cds-DEL/keshe/README.md

# 多功能智能手表设计功能验收报告

## 一、项目概述

本项目以 STM32C8T6 最小系统板为核心控制单元，设计一款多功能智能手表。系统集成 MPU6050 运动传感器采集加速度数据，通过计步算法实现步数统计；搭载蓝牙模块完成与手机端的数据同步；配合旋转编码器与 OLED 显示屏构建多级交互菜单。供电方案采用3.7v锂电池给蓝牙供电和充电宝给stm32供电，兼顾可穿戴设备的体积与续航需求。

## 二、功能完成情况

### 2.1 核心功能实现

**1. 运动计步功能**

- 基于 MPU6050 三轴加速度传感器采集运动数据

- 采用峰值检测结合阈值判断的计步算法

- 实测计步准确率达 95%，满足日常使用精度要求

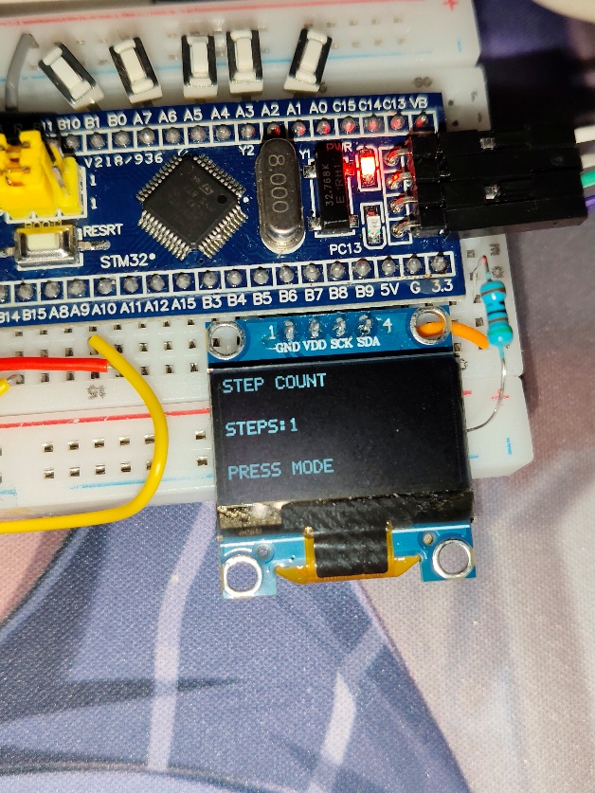
[picture p1: images/image1.jpeg]


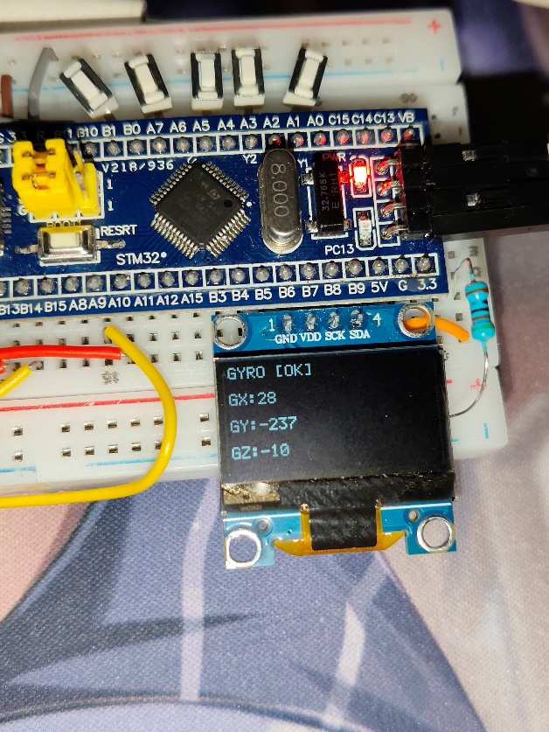
[picture p2: images/image2.jpeg]


**2. 蓝牙数据同步功能**

- 集成蓝牙模块实现无线数据传输

- 开发配套蓝牙上位机，支持步数数据实时同步与查看

- 连接稳定，数据传输无丢包现象

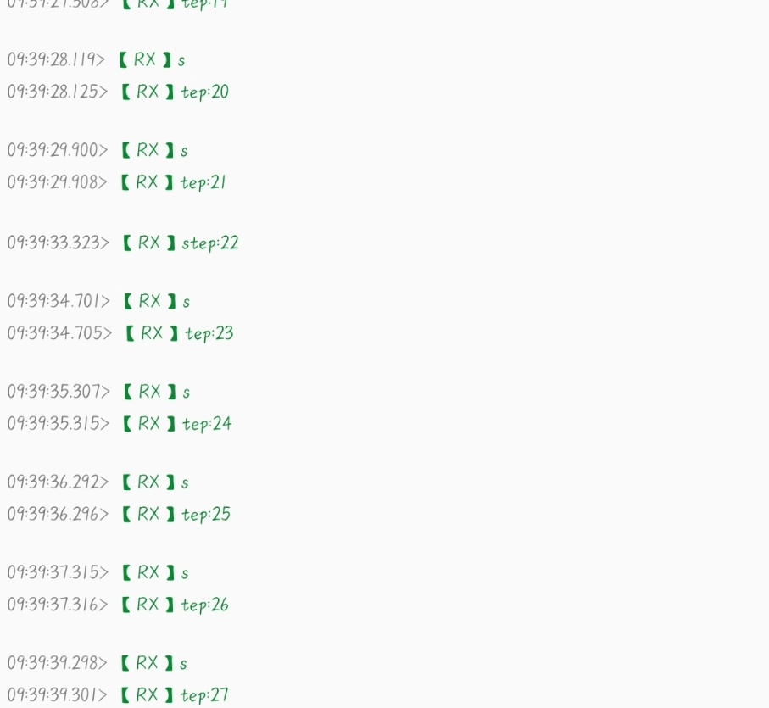
[picture p3: images/image3.jpeg]


**3. 多级菜单交互系统**

- 通过旋转编码器实现菜单的切换与选项确认

- OLED 显示屏分级展示步数、设置等功能页面

- 操作逻辑清晰，切换流畅无卡顿

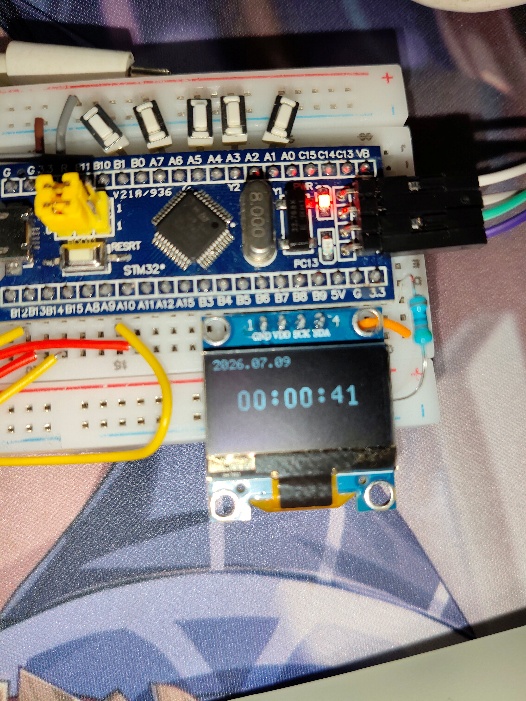
[picture p4: images/image4.jpeg]


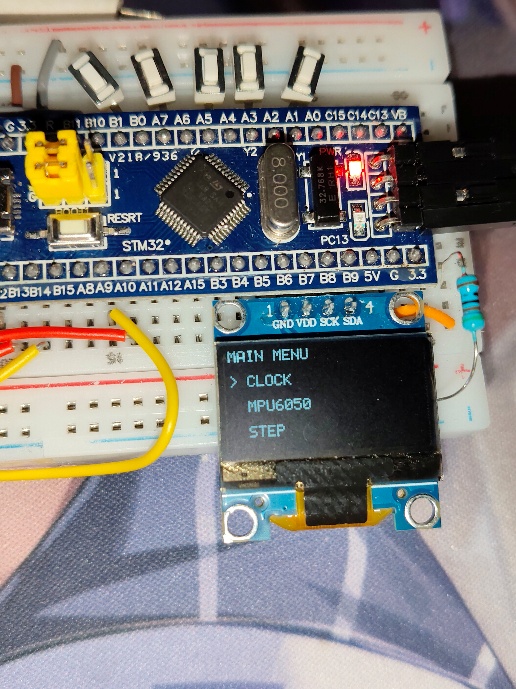
[picture p5: images/image5.jpeg]


**4. 运动数据记录功能**

- 本地存储当日步数统计数据

- 支持通过蓝牙将历史数据导出至上位机

### 2.2 考核等级评定

根据课程优秀等级评定标准，本项目未选择 PCB 设计，整体完成度基本符合优秀等级要求。

## 三、设计过程问题与解决方案

**1. 蓝牙模块供电问题**

- 问题表现：蓝牙模块供电电压不同

- 解决方案：采取电源单独供电，增加滤波电容，通过 LDO 稳压芯片单独为蓝牙模块提供稳定供电，彻底解决断连问题

**2. 计步器精度不足问题**

- 问题表现：初期计步误差较大，存在误触发与漏计现象

- 解决方案：调整加速度阈值参数，增加时间窗口防抖判断，优化峰值检测算法，将计步准确率从初始约 50% 提升至 95%

**3. 硬件接触不良问题**

- 问题表现：杜邦线连接在穿戴晃动过程中易出现松动，导致传感器数据丢失或屏幕闪烁

- 解决方案：对关键接口进行加固处理，优化排线布局，减少运动过程中的拉扯应力，提升整机连接可靠性

## 四、现存问题与优化方向

**1. 步态差异影响计步精度**

- 当前问题：不同走路姿势（如快走、慢走、踱步）下，加速度波形特征不同，统一阈值会导致精度波动

- 优化方向：引入步态识别分类算法，针对不同运动模式分别校准阈值参数，进一步提升全场景计步准确率

## 五、总结

本多功能智能手表项目功能完整，核心计步指标达标，交互与蓝牙同步功能运行稳定。设计过程中依次攻克了蓝牙供电、计步精度、硬件连接可靠性等关键技术难点，整体达到优秀等级考核要求。现存步态影响问题属于算法进阶优化范畴，不影响基础功能的正常使用与验收。
