cds-DEL/keshe/Mid-term Inspection Report.md

# 项目中期检查报告

## 一、物料到位总览
本项目全部所需物料均已到货，无物料缺失、延期情况。
物料明细：STM32F103最小系统板、MPU6050六轴传感器、HC05蓝牙模块、SSD1306 OLED显示屏、EC11旋转编码器、HT7333 LDO降压芯片、3.7V单节锂电池、分压电阻、滤波电容、杜邦线、充电宝等供电配套配件。

## 二、当前完成进度
### 1. 已完成工作
1. 硬件整体电路搭建，各模块基础接线、布局完成；
2. 使用STM32CubeMX完成工程初始化，成功移植FreeRTOS实时操作系统；
3. 全部基础功能软件代码开发完毕：
    - OLED多页面界面切换、EC11编码器旋钮/按键交互逻辑；
    - 设备实时时钟计时功能；
    - MPU6050三轴加速度、陀螺仪原始数据读取；
    - HC05蓝牙串口双向数据收发传输；
    - 基础版陀螺仪阈值计步代码；
4. 各外设独立模块USB供电测试，单项功能运行正常。

### 2. 进行中工作
1. 计步算法优化：新增加速度峰谷检测，搭配陀螺仪联合校验，降低误计、漏步；
2. 锂电便携供电电路调试，解决蓝牙上电失败、震动断电故障；
3. 时钟拓展功能方案设计，计划增加日期、星期显示。

### 3. 未开始工作
1. 整机长时间稳定性压力测试；
2. 全功能联调验收；
3. 项目完整文档、演示素材整理。

## 三、硬件调试情况
### 1. 各模块测试结果
| 硬件模块 | 测试状态 | 现象说明 |
| ---- | ---- | ---- |
| STM32主控、OLED、EC11、MPU6050 | 正常 | USB供电下数据读取、屏幕刷新、菜单切换无异常 |
| HC05蓝牙模块 | 异常（锂电供电） | USB板载3.3V供电可点亮、正常收发；锂电池经HT7333降压供电时无法上电 |
| HT7333电源电路 | 空载正常 | 输入、输出均加装滤波电容，无负载时稳定输出3.3V，带载能力不足 |

### 2. 当前硬件问题与解决措施
#### 问题1：3.7V锂电池+HT7333供电时，HC05蓝牙模块无法上电点亮
- 故障原因：HT7333最大输出电流仅100mA；STM32+OLED+MPU静态负载约40~60mA，HC05上电峰值电流70~80mA，瞬时总电流超出芯片额定值，触发限流，电压跌落导致蓝牙欠压保护。
- 整改方案：
  1. 优先方案：双路独立稳压供电，锂电池分出两路，一路HT7333给主控与传感器，第二颗HT7333单独为HC05供电，所有模块GND共地；
  2. 备选方案：更换大电流低压差LDO（XC6206-3.3，额定500mA输出）替换HT7333，满足整机峰值电流需求。

#### 问题2：锂电池供电时，设备晃动、移动过程中偶尔断电重启
- 故障原因：
  1. 供电接线、焊点存在虚接，震动时供电回路断开；
  2. 瞬时负载电流波动大，现有电容缓冲能力不足，动态压降过大。
- 整改方案：
  1. 重新焊接全部电源、地线引脚，加粗共地导线，缩短电源走线长度，降低线路内阻；
  2. 在LDO输出端、HC05电源引脚额外并联10μF钽电容，提升瞬时电流缓冲能力。

## 四、软件调试情况
### 1. 各功能模块开发进度
| 功能模块 | 开发状态 | 测试结果 |
| ---- | ---- | ---- |
| OLED界面+EC11编码器菜单切换 | 已完成 | 多页面切换流畅，旋钮、按键响应无卡顿、丢指令 |
| 实时时钟基础计时 | 已完成 | 计时稳定，基础时钟页面正常渲染 |
| MPU6050六轴数据采集 | 已完成 | I2C通信稳定，三轴加速度、陀螺仪数据读取无丢失 |
| HC05蓝牙数据收发传输 | 已完成 | USB供电下可稳定上传步数、传感器数据 |
| 基础计步功能 | 优化迭代中 | 基础计数逻辑可用，存在甩手误计、行走漏步缺陷 |
| 时钟日期/星期拓展功能 | 未开发 | 仅完成设计方案，待硬件、计步优化完成后开发 |

### 2. 已通过测试用例
1. 外设单项通信测试：I2C驱动OLED/MPU6050、USART蓝牙收发全部稳定通过；
2. FreeRTOS多任务并发测试：屏幕刷新、传感器采集、蓝牙后台传输并行运行，无任务阻塞；
3. 编码器交互测试：旋转切换光标、短按切换页面功能无异常。

## 五、存在的问题、风险及应对方案
### 1. 技术难点风险
1. **计步算法精度不足**
    - 风险：仅依靠陀螺仪单阈值判断，原地甩手、颠簸震动会产生误计数，正常行走存在漏步，计步误差过大。
    - 应对：完善加速度+陀螺仪双重校验逻辑，新增合加速度峰谷检测；增加滑动均值滤波消除传感器噪声；设置最小迈步时间防抖锁，过滤短时间虚假触发。
2. **锂电便携供电不稳定**
    - 风险：蓝牙无法上电、震动断电会直接导致项目便携核心功能失效。
    - 应对：优先实施双LDO独立供电方案，同步完成接线加固、电容扩容；整改后进行1小时手持震动压力测试，验证供电稳定性。

### 2. 项目进度风险
- 风险：硬件电源整改、计步算法优化耗时较长，可能延后时钟拓展、整机联调工作。
- 应对：小组并行分工，硬件、软件同步推进；提前搭建时钟日期功能代码框架，硬件故障修复后快速完成拓展功能开发。

## 六、后续工作计划（至项目验收前）
### 阶段1（1日内）：硬件供电故障整改
1. 加装第二路HT7333，实现HC05独立供电，重新焊接所有电源、地线；
2. 锂电池手持震动测试，验证蓝牙稳定上电、整机无断电重启。

### 阶段2（2日内）：软件功能完善
1. 完成加速度+陀螺仪联合校验计步代码调试，多次行走实测，控制误步、漏步误差；
2. 开发时钟页面日期、星期拓展功能，整合进原有界面逻辑。

### 阶段3（1日内）：整机全功能联调
1. 锂电池供电下全功能同步测试：时钟、计步、菜单交互、蓝牙数据传输；
2. 修复联调产生的屏幕卡顿、数据乱码、显示异常等bug。

### 阶段4（验收前1日）：收尾准备
1. 长时间整机稳定性压力测试；
2. 整理工程代码、硬件接线图纸、演示视频、全套项目文档，准备验收展示材料。

### 小组分工调整
1. 硬件负责人：电源电路改造、焊接、整机硬件测试；
2. 算法负责人：计步滤波、双条件校验代码迭代优化；
3. 界面软件负责人：时钟日期拓展功能开发、OLED界面美化；
4. 统筹负责人：整机联调测试、中期/验收文档整理。
