cds-DEL/keshe/sysDesign.md

# 基于STM32F103C8T6的智能手表系统设计文档
小组成员：李盛杰、陈冬胜、郑開之<br>
编制日期：2026年07月01日<br>
项目实现形式：STM32最小系统板+面包板搭建硬件，无PCB设计<br>
实现功能范围：全部基础功能 + 扩展1（旋转编码器多级菜单）+ 扩展2（蓝牙数据同步与上位机）+ 扩展4（运动计步算法与数据记录）

## 1 物料到位情况说明
### 1.1 已有物料清单（全部到位）
本小组前期自备器材完好可用，无需采购、无需等待到货，可直接用于项目开发，具体清单如下：
- STM32F103C8T6最小系统板：项目主控核心，正常上电、下载程序无故障
- 1.3寸 I2C接口OLED显示屏：用于系统界面、时间、传感器数据、菜单显示
- ST-Link V2下载器：用于程序烧录、在线调试
- 面包板、杜邦线、基础工具包：用于硬件电路搭建与接线

### 1.2 待采购物料清单（未到货）
本次项目扩展功能所需外设模块、电源配套器件均已统一采购，截至2026年07月01日暂未到货，预计2026年07月03日全部到货，可保障07月06日中期检查节点顺利完成硬件搭建与基础调试。具体采购物料明细如下：

| 物料名称 | 型号规格 | 用途 |
|---|---|---|
| MPU6050/GY521六轴陀螺仪模块 | I2C通信、2.54mm直插引脚，适配面包板 | 采集三轴加速度、角速度数据，为计步算法、姿态检测提供原始数据 |
| EC11旋转编码器 | 带按键直插款，适配面包板 | 实现多级菜单切换、功能选择、参数调节 |
| HC-05蓝牙串口模块 | 2.54mm直插排针，串口透传 | 实现手表与手机上位机数据同步、指令交互 |
| TP4056 Type-C充电保护模块 | Type-C接口，支持锂电池充电与过充保护 | 系统电源充电管理，实现外接供电充电功能 |
| 3.7V锂电池 | 6516 150mAh，带保护板、2.0插头引线 | 系统离线续航供电 |
| HT7333 LDO稳压芯片 | TO92直插封装，3.3V稳压输出 | 为MCU、传感器、显示屏提供稳定3.3V工作电压 |
| 1N4148开关二极管 | 轴向直插2.54mm引脚 | 电源电路防反接、电路保护 |
| 电阻电容套件 | 1k/10k/47k电阻、100nF/10uF电容，1/4W直插 | 电路限流、滤波、外设匹配 |

## 2 系统总体方案设计
### 2.1 系统设计总体概述
本项目基于STM32F103C8T6主控芯片，以FreeRTOS实时操作系统为核心，搭建多功能嵌入式智能手表系统。系统集成电源管理、OLED显示、姿态传感采集、编码器人机交互、蓝牙数据通信、运动计步六大核心功能，采用面包板搭建硬件电路，无PCB设计。通过多任务实时调度实现界面刷新、传感器采样、数据运算、蓝牙交互并行运行，最终实现时间显示、姿态检测、多级菜单操作、运动计步记录、手机蓝牙数据同步等完整功能，满足课程设计基础要求及多项扩展要求。

### 2.2 系统四层总体架构
1. 硬件层：包含主控最小系统、电源模块、OLED显示模块、MPU6050传感模块、EC11编码器模块、HC-05蓝牙模块，为系统提供硬件运行基础。
2. 驱动层：基于STM32标准库开发I2C驱动、串口驱动、定时器驱动、编码器中断驱动，实现底层硬件的读写与控制。
3. RTOS系统层：移植FreeRTOS内核，完成任务划分、优先级配置、信号量与消息队列通信配置、SysTick时钟节拍配置，实现多任务实时调度。
4. 应用功能层：实现时间计时、OLED界面显示、姿态数据解析、多级菜单交互、计步算法运算、运动数据存储、蓝牙数据同步等上层业务功能。

### 2.3 硬件架构示意图（文字框图）
```
                    手机上位机
                        ↑
                        │
                        ↓
               HC-05蓝牙模块 (USART串口)
                        ↑
                        │
                        ↓
电源模块(TP4056+HT7333) → STM32F103C8T6主控 ← EC11编码器(外部中断)
                        ↓
                        │
                        ↓
              OLED显示屏  ←I2C总线→  MPU6050陀螺仪
                        ↑
                        │
                        ↓
              SysTick定时器(计时+RTOS节拍)
```

### 2.4 软件系统流程图（文字版）
```
系统上电
    ↓
硬件外设初始化(GPIO/I2C/USART/TIM/EXTI)
    ↓
底层驱动初始化(OLED/MPU6050/编码器/蓝牙)
    ↓
FreeRTOS内核初始化(堆内存、任务、信号量、消息队列)
    ↓
开启全局中断，启动任务调度器
    ↓
多任务并行循环运行：
    1.时间更新任务  2.OLED显示任务  3.传感器采集任务
    4.计步运算任务  5.菜单交互任务  6.蓝牙通信任务
    ↓
实时采集数据、运算计步、刷新界面、响应蓝牙指令
    ↓
持续循环调度运行
```

## 3 硬件详细设计
### 3.1 核心主控电路设计
主控采用STM32F103C8T6最小系统板，板载复位电路、8MHz外部晶振、BOOT启动配置电路，无需自行绘制核心电路。全板外设统一由HT7333输出3.3V供电，匹配MCU额定工作电压。

### 3.2 电源电路设计
电源系统分为充电电路与稳压供电电路两部分：
- 充电电路：TP4056 Type-C一体化充电模块，支持5V外接输入为3.7V锂电池充电，内置过充、过放、短路保护。
- 稳压电路：锂电池输出电压范围3.0~4.2V，经过HT7333线性LDO稳压至稳定3.3V；串联1N4148二极管实现电源防反接，输入输出端并联100nF滤波电容，降低电压纹波。

### 3.3 外设接口电路设计
#### 3.3.1 I2C外设电路（OLED+MPU6050）
主控硬件I2C1引脚：PB6(SCL)、PB7(SDA)，两条总线各外接10kΩ上拉电阻至3.3V。OLED与MPU6050挂载同一组I2C总线，依靠不同设备地址区分通信对象，节省IO资源，布线简洁。

#### 3.3.2 EC11旋转编码器电路
编码器A、B两相引脚分别接入PA0、PA1外部中断引脚，中间按键引脚接入PA2普通GPIO；编码器公共端接GND，IO口内部上拉，双边沿中断检测旋转动作，实现菜单切换、数值调节，短按确认菜单选项。

#### 3.3.3 HC-05蓝牙串口电路
HC-05模块TX接STM32 USART1 RX(PA10)，HC-05 RX接STM32 USART1 TX(PA9)；模块VCC接3.3V，GND共地，波特率固定9600，8N1串口模式，实现双向透传数据交互。

### 3.4 关键元件参数计算
1. 稳压参数：HT7333输入耐压12V，压差仅0.3V，锂电池3.0~4.2V输入可稳定输出3.3V，满足所有外设工作电压。
2. I2C上拉电阻：10kΩ匹配400kHz高速I2C时序，总线电平稳定，无通信丢包。
3. 整机功耗估算：系统静态运行电流约20mA，150mAh锂电池理论续航7.5小时，完全满足实验室调试需求。

### 3.5 硬件布局规划（面包板无PCB）
1. STM32最小系统板放置面包板中间区域，缩短所有外设接线长度，减少信号干扰；
2. 电源模块、锂电池统一布置在面包板最左侧，远离I2C、串口信号线；
3. OLED显示屏、EC11编码器布置外侧，方便实时观察界面与手动操作；
4. MPU6050、HC-05蓝牙分区放置，电源线与信号排线分开走线；
5. 模块分区清晰，接线有序，便于后期故障排查、线路整改。

## 4 软件详细设计
### 4.1 软件整体模块划分
系统软件分层模块化开发，七大核心模块相互解耦：
底层驱动模块、系统计时模块、FreeRTOS任务调度模块、OLED显示UI模块、传感器采集&计步模块、编码器菜单交互模块、蓝牙通信模块。

### 4.2 FreeRTOS任务划分与调度设计
系统采用抢占式调度，SysTick配置1ms系统节拍，共创建6个独立任务，参数如下：

| 任务名称 | 优先级 | 堆栈大小 | 任务功能 | 运行机制 |
|---|---|---|---|---|
| 时间更新任务 | 4（最高） | 128 | SysTick累加计时，更新时分秒全局变量 | 1s周期阻塞运行 |
| 传感器采集任务 | 3 | 256 | 定时读取MPU6050三轴加速度、角速度 | 10ms定时采集 |
| 计步运算任务 | 3 | 256 | 数据滤波、峰值检测、步数累加、本地存储 | 传感器数据队列触发运行 |
| OLED显示任务 | 2 | 128 | 渲染时间页、传感器数据页、多级菜单页面 | 20ms周期刷新 |
| 菜单交互任务 | 2 | 128 | 检测编码器旋转、按键事件，切换菜单层级 | 事件阻塞，无操作休眠 |
| 蓝牙通信任务 | 1（最低） | 256 | 接收手机指令、上传计步/时间数据 | 串口中断唤醒处理 |

### 4.3 任务间通信与同步设计
1. 二值信号量：I2C总线互斥信号量、OLED屏幕互斥信号量，防止多任务同时占用硬件造成通信错乱、花屏。
2. 消息队列：传感器数据队列、蓝牙收发数据队列，实现任务异步数据传输，降低耦合。
3. 阻塞休眠机制：无数据、无操作时任务进入阻塞态，释放CPU资源，降低系统整体功耗。

### 4.4 核心计步算法描述（扩展4核心）
采用滑动窗口均值滤波+三轴合成加速度峰值阈值算法：
1. 预处理：对MPU6050原始三轴加速度做5阶滑动平均滤波，滤除手部高频抖动噪声；
2. 合成加速度计算：sqrt(Ax²+Ay²+Az²)，消除手表佩戴倾斜带来的数值偏移；
3. 峰值检测：识别合成加速度连续“波峰-波谷”周期性变化；
4. 防抖阈值：设置300ms最小步间隔，过滤小幅抬手、晃动误计数；
5. 数据存储：累计当日总步数，变量缓存历史步数，支持蓝牙指令清零、数据上传手机上位机。

### 4.5 外设配置方案
1. I2C1：时钟400kHz高速模式，PB6/PB7复用I2C功能；
2. USART1：波特率9600，数据位8，停止位1，无校验，开启接收中断；
3. SysTick：1ms中断，作为FreeRTOS系统时钟节拍与软件计时基准；
4. 外部中断EXTI0/EXTI1：编码器A/B双边沿触发，上升下降沿均可检测旋转方向；
5. 低功耗配置：空闲任务开启STOP低功耗模式，闲置外设时钟关闭，降低功耗。

## 5 进度汇报
### 5.1 当前完成情况（截止2026-07-02汇报节点）
1. 完成全部基础功能、扩展1/2/4需求梳理，确定面包板硬件搭建方案，放弃PCB设计；
2. 完成自备物料清点、采购物料清单统计、项目预算核算；
3. 完成硬件框图、软件流程图、FreeRTOS任务架构、计步算法方案设计；
4. 完成STM32工程框架搭建、FreeRTOS内核移植、底层驱动函数框架编写；
5. 完成本系统设计文档全部撰写，整理小组分工、全周期项目里程碑。

### 5.2 后续工作计划
1. 2026.07.02 - 07.05：采购物料全部到货清点，完成面包板整机硬件接线，调试电源与各模块基础通信；
2. 2026.07.06 中期检查：基础OLED时间显示、MPU6050数据采集调试完成，实现基础计步逻辑，提交中期检查报告；
3. 2026.07.06 - 07.09：完善多级菜单、蓝牙双向同步、优化计步滤波算法、运动数据本地存储，整机联调修复bug，录制功能演示视频；
4. 2026.07.09 初次验收：全部基础+扩展功能完整实现，现场整机演示，记录修改意见；
5. 2026.07.09 - 07.10：根据初验意见修复软硬件缺陷，校准计步精度、优化蓝牙稳定性，整理答辩PPT；
6. 2026.07.10 最终验收：整机稳定运行，完成项目评分；
7. 验收后一周：每位组员独立完成LaTeX个人总结报告并归档。

## 6 小组分工说明
1. 陈冬胜（硬件负责人）
物料选型采购、到货核对、硬件框图绘制、面包板整机接线搭建、电源电路调试、MPU6050/OLED/编码器/蓝牙硬件故障排查、答辩讲解硬件整体方案。

2. 李盛杰（软件负责人）
STM32工程创建、FreeRTOS移植与任务划分、全套底层驱动开发、软件计时、多级菜单逻辑、三轴计步滤波算法、蓝牙上下位机通信、整机软件联调、代码整理与软件架构讲解。

3. 郑開之（文档&测试负责人）
项目计划书、系统设计文档、中期检查报告、验收材料全套撰写；计步精度、蓝牙通信、长时间稳定性专项测试；录制演示视频、制作答辩PPT；汇总硬件图纸、源代码、测试记录；答辩主讲，记录教师修改意见同步软硬件负责人。

### 公共协作任务
三人共同讨论整体系统方案，核对全部功能需求；联合整机长时间稳定性测试，验证多任务同步运行无卡顿；软硬件资料统一共享，交叉检查文档、代码错误。

## 7 可行性与风险规避
### 7.1 可行性分析
硬件全部采用通用成熟模块，资料丰富、调试门槛低；FreeRTOS任务划分逻辑清晰，通信机制成熟；计步、蓝牙、菜单功能均有成熟开源参考方案，结合组员软硬件开发能力，可完整实现全部基础与扩展功能。

### 7.2 风险及解决措施
1. 物料延期：预留3天缓冲调试周期，不影响中期检查节点；
2. 计步计数误差：多级滤波+动态阈值校准，多次实测调整参数；
3. 多任务资源冲突：信号量互斥访问硬件，合理分配任务优先级避免死锁；
4. 蓝牙通信不稳定：增加数据校验位、重传机制，优化串口中断处理逻辑。

---

## 附：核心框架示例代码
```c
/* FreeRTOS任务创建核心代码片段 main.c */
#include "stm32f10x.h"
#include "FreeRTOS.h"
#include "task.h"
#include "queue.h"
#include "semphr.h"
#include "oled.h"
#include "mpu6050.h"
#include "encoder.h"
#include "bluetooth.h"

/* 全局句柄定义 */
SemaphoreHandle_t xI2CSemaphore;
QueueHandle_t xSensorDataQueue;

/* 任务函数声明 */
void vTimeTask(void *pvParameters);
void vSensorTask(void *pvParameters);
void vStepCountTask(void *pvParameters);
void vOledDispTask(void *pvParameters);
void vMenuTask(void *pvParameters);
void vBtCommTask(void *pvParameters);

int main(void)
{
    //硬件底层初始化
    STM32_Init();
    OLED_Init();
    MPU6050_Init();
    Encoder_Init();
    Bluetooth_Init();

    //RTOS资源创建
    xI2CSemaphore = xSemaphoreCreateBinary();
    xSemaphoreGive(xI2CSemaphore);
    xSensorDataQueue = xQueueCreate(16, sizeof(MPU6050_Data));

    //创建6个业务任务
    xTaskCreate(vTimeTask, "TimeTask", 128, NULL, 4, NULL);
    xTaskCreate(vSensorTask, "SenTask", 256, NULL, 3, NULL);
    xTaskCreate(vStepCountTask, "StepTask", 256, NULL, 3, NULL);
    xTaskCreate(vOledDispTask, "OledTask", 128, NULL, 2, NULL);
    xTaskCreate(vMenuTask, "MenuTask", 128, NULL, 2, NULL);
    xTaskCreate(vBtCommTask, "BtTask", 256, NULL, 1, NULL);

    vTaskStartScheduler();
    while(1);
}

//计步算法核心片段
void Step_Calc(MPU6050_Data data)
{
    float acc = sqrtf(data.ax*data.ax + data.ay*data.ay + data.az*data.az);
    static float buf[5];
    static uint8_t idx = 0;
    static uint32_t step_time = 0;
    static uint32_t step_cnt = 0;

    //滑动平均滤波
    buf[idx++] = acc;
    if(idx >= 5) idx = 0;
    float avg = (buf[0]+buf[1]+buf[2]+buf[3]+buf[4])/5.0f;

    //峰值阈值判断+防抖间隔
    if(avg > 1.2f && (millis()-step_time)>300)
    {
        step_cnt++;
        step_time = millis();
    }
}
```
