cds-DEL/keshe/智能手表功能报告.md

- **多功能智能手表功能详细说明**

一、硬件构成

- 主控芯片：STM32C8T6 最小系统板，负责整机逻辑调度与数据处理

- 运动传感器：MPU6050 三轴加速度计，实时采集手腕运动加速度数据

- 显示模块：OLED 显示屏，用于菜单界面与步数数据展示

- 输入设备：旋转编码器，实现菜单切换与选项确认

- 蓝牙模块：负责与手机/上位机的无线数据通信

- 供电系统：3.7v锂电池给蓝牙供电和充电宝给stm32供电

二、运动计步功能

- 实现原理：通过 MPU6050 采集三轴加速度波形，识别走路时的周期性峰值特征

- 核心算法：采用阈值判断 + 时间窗口防抖的峰值检测算法，过滤误触发

- 精度指标：正常步行场景下计步准确率约 95%

- 局限：不同走路姿势（快走/慢走/踱步）下精度存在小幅波动

三、蓝牙数据同步功能

- 数据传输：将手表本地步数数据无线发送至配套上位机

- 上位机功能：蓝牙端软件可实时查看步数、同步历史记录

- 连接稳定性：优化供电后连接可靠，数据传输无明显丢包

四、多级菜单交互系统

- 操作方式：旋转编码器旋钮切换选项，按下确认进入

- 菜单层级：包含步数主页、数据查看、系统设置等多级页面

- 显示效果：OLED 屏幕界面清晰，菜单切换流畅无卡顿

五、运动数据记录功能

- 本地存储：手表端保存当日步数统计数据

- 数据导出：可通过蓝牙将记录同步至上位机进行查看与留存

- 使用场景：支持日常运动数据的累计统计与追溯

六、电源管理

- 供电方案：3.7v锂电池给蓝牙供电和充电宝给stm32供电

- 问题解决：设计初期蓝牙模块启动电流导致的供电波动已通过电路优化解决

- 可穿戴适配：整体功耗控制满足手表类设备的基本续航需求
