cds-DEL/keshe/plan.md

基于STM32F103C8T智能表项目计划书

李盛杰  陈冬胜，郑開之  
2026年06月30日

## 项目基本信息
- 课题名称：基于STM32F103C8T6的智能手设计
-组人数：人
- 实现方案：不制作PCB，采用STM32最小系统+面包板搭建硬
- 已有器材：STM32F103C86最小系统板、OLED显示屏、ST-Link V2下载器、孔迷你包，无需重复采购
- 完成要求：全部要求 + 扩展1（旋编码器+OLED多级菜单）+展2（牙手机数据同步与上位机）+ 扩4运动计步算法与运动数据记录），不开展PCB设计扩展
- 实验地点：理学馆

## 工作计划（题至验收详细时间节点与里程碑）
完全按照课程设计官方时间安排规划，各阶段里程碑如下：
1. **2026-06-29 09:00 选题确认里程碑**  
 小组确定智能手表课题，梳理基础功能、扩展1、扩展2、扩展4全部需求；确定不制作PCB，全程使用面包板搭建硬件电路，对小组已有器材清单，剔除采购物料。
   
2. **2026-06-30 09:00 项目书提交里碑**  
   完物料统计、人员分工、完整计划书写，提交指导教师审核。

3. **2026-07-02 09: 系统设计文档与分组汇报里程碑**  
  成件框图、软件流程图、FreeRTOS任务架构、外设接线示意图；完成计步算法原设计提交《系统设计文档》并上台汇报整体方案。

4. **202607-06 15:00期检查里碑**  
   全采购物料到货；面包板硬件搭建完毕；基础功能（OLED时间显示、MPU0姿态数据采集）调试通过；完成基础计步逻辑开发；提交《期检查报告》。

5. **2026--09 09:00 第一次验收里程碑**  
   全部基础功能、编码器菜单、蓝牙通信、完整计步与数据存储功能试完成；录制演示视频，现场整机演示记录教师提出的修改意见。

6. **2026--10 09:00 第二最终验收里程碑**  
  初验意见修改软硬件缺陷整机功能稳定运行，计步数据记录准确蓝牙同步正常，项目最终成绩评定7. **验收后一周 总结报告提交程碑**  
   每位组员独立使用LaTeX模板完成个人总结并提交存档。

 分阶段细化工作安排
1. 06.29--06.30：需求梳理、物料清单整理、剔已有器材人员分工、撰本项目计划书，确定计步算法实现方案
2.  06.30--.02：硬件接线方案设计、FreeRTOS工程搭、外设驱动架编写计步算法逻辑设计、设计文档撰写
3. 06.30–07.02.：物料收货清点、面包板硬件接线、各外设动试、多任务联调、计步功能调试
4. 07.02--07.09：优化计步滤算法、增加运动数据存储记录、蓝牙上位机双向通信调试、整机全测试、录制演示视频、整理验收材料
5. 07.09--07.10修复初验提出Bug、整机复测、计步精校准、准备答辩演示材料

## 物料采购计划
| 料名称 | 型规格 | 小计元) | 购买途径 |
|---|---|---|---|
| MPU6050/GY521六轴陀螺仪模块 | I2通信，2.54mm直插排针适配面包板 | 14.00 | 淘宝 |
| EC11旋转编码器 | EC带按键引脚直插款，面包板专用 |2.90  | 淘宝 |
| HC-05蓝牙串模块 |2.54mm直排针，串口透传 |33.98 | 淘 宝 |
| TP405 Type-C充电保护一体模块 | Type-C接口预焊4根引导，剥线直插面包 | 6.65 | 淘宝 |
| 锂聚物电池 | 651 3.V 150mAh内置保护板，2.0插头引线 | 17.00 | 淘宝 | HT7333稳压芯片 | HT7333 TO92直插三脚LDO，适配面包 | 3.20 | 淘宝 |
| 14148开关二管 | 轴向直插，2.54mm脚配面包板 | 4.  48 | 淘宝 | 
|直插电阻电包 |1k/10k/47k电阻+100nF/uF电，1/4W轴向直插 | 1000 | 淘宝 |

需采购物料总预算合计：92.21元

## 小组分工方案

### 陈冬胜:硬件负责人
1. 物料选型、下单采购、收清核对，物料成本；
2. 绘制硬件整体框图、各模块接线示意图3. 面板整体硬件搭建、线路检查源电路调试；
4. MPU6050、OLED、EC11编码、HC05蓝牙模块硬件接线与通信故障排查；
5. 配合步功能调试，排查传感硬件采样异常问题；
6.理硬件数据、接线图纸，答辩讲解硬件整体方案。

### 李盛杰：软件负责人核心，含扩展4计开发
1. STM32工程创建、FreeRTOS实时操作系统移植、多任务分（显示、传感器采集、蓝牙通信、计步存储）；
2. 编写层驱动：OLED显示驱动、U6050速度、EC11编码器串HC05蓝牙驱动；
3. 实现功能：软件计时、多级交互菜单；
4. 完成扩展4核心三轴加速度滤波算法、阈值判断步辑、本地运动步数存、历史数据缓存；
5. 开发扩展蓝双向通信：手机同步时间上传日计步数据、程清零步数
6. 整机软件联调，校计步精，修复程序卡顿、数据丢失、牙断连等bug
7. 整理完整源代码、软件流程图、计步算法说明，答辩讲解程序架。

### 郑開之：文档与测试负责人
1. 撰写全文档：本项目计划书、系统设计文档、中期检查、验收材料；
2. 专项测试：计步精度重复性测试、长时间运动数据储稳定性测试、牙数据同步；
3. 记录测试数据、截图、故障象与对应解决方法；
4. 录制完整功能演示，制作答辩汇报PPT；
5.  统一汇总硬件图纸、软件代码、计步测试记录规范所有报告格式；
6. 收后指导小组全员LaTeX总结报告；
7. 答辩汇人，记录教师修改意见并同步给硬件、软件负责人。

### 公共协作任务
1. 三人共同讨论项目整体方案，核对基础全部扩展功能需求；
2. 联合开展整机时间稳定性测试，验证计步、蓝牙、显示同步运行无异常；
3. 硬件图纸代码、文统一共享，互相交叉错误
