cds-DEL/keshe/Core/Src/main.c

git log origin/main
git log main/* USER CODE BEGIN Header */
/**
  ******************************************************************************
  * @file           : main.c
  * @brief          : Main program body
  ******************************************************************************
  * @attention
  *
  * Copyright (c) 2026 STMicroelectronics.
  * All rights reserved.
  *
  * This software is licensed under terms that can be found in the LICENSE file
  * in the root directory of this software component.
  * If no LICENSE file comes with this software, it is provided AS-IS.
  *
  ******************************************************************************
  */
/* USER CODE END Header */
/* Includes ------------------------------------------------------------------*/
#include "main.h"
#include "cmsis_os.h"
#include "i2c.h"
#include "usart.h"
#include "gpio.h"
#include "app_input.h"
#include "app_ui.h"
#include "app_mpu6050.h"
#include <stdio.h>
#include <string.h>
#include "ssd1306.h"
#include <math.h>

/* USER CODE BEGIN PM */
#define STEP_ACCEL_WINDOW_SIZE           5
#define STEP_ACCEL_PEAK_OFFSET           1000
#define STEP_ACCEL_VALLEY_OFFSET         700
#define STEP_ACCEL_RESET_OFFSET          900
#define STEP_GYRO_THRESHOLD              700
#define STEP_GYRO_UNLOCK_THRESHOLD       300
#define STEP_BASELINE_SMOOTH_FACTOR      8
#define STEP_DEBOUNCE_STABLE_SAMPLES     3

/* USER CODE END PM */


/* USER CODE BEGIN PV */
uint8_t mpu6050_ok = 0;
/* USER CODE END PV */

void SystemClock_Config(void);
void MX_FREERTOS_Init(void);
/**
  * @brief  The application entry point.
  * @retval int
  */
int main(void)
{

  /* MCU Configuration--------------------------------------------------------*/

  /* Reset of all peripherals, Initializes the Flash interface and the Systick. */
  HAL_Init();

  /* Configure the system clock */
  SystemClock_Config();

  /* Initialize all configured peripherals */
  MX_GPIO_Init();
  MX_I2C1_Init();
  MX_I2C2_Init();
  MX_USART1_UART_Init();
  /* USER CODE BEGIN 2 */
  ssd1306_Init();
  mpu6050_ok = (AppMpu6050_Init() == HAL_OK) ? 1 : 0;
  AppUi_ShowMainMenu(0);
  /* USER CODE END 2 */

  /* Init scheduler */
  osKernelInitialize();  /* Call init function for freertos objects (in cmsis_os2.c) */
  MX_FREERTOS_Init();

  /* Start scheduler */
  osKernelStart();

  /* We should never get here as control is now taken by the scheduler */

  /* Infinite loop */
  /* USER CODE BEGIN WHILE */
  while (1)
  {
    /* USER CODE END WHILE */

    /* USER CODE BEGIN 3 */
    /* Application logic moved to StartDefaultTask in freertos.c */
    /* USER CODE END 3 */
  }
}

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
/**
  * @brief  Period elapsed callback in non blocking mode
  * @note   This function is called  when TIM1 interrupt took place, inside
  * HAL_TIM_IRQHandler(). It makes a direct call to HAL_IncTick() to increment
  * a global variable "uwTick" used as application time base.
  * @param  htim : TIM handle
  * @retval None
  */
void HAL_TIM_PeriodElapsedCallback(TIM_HandleTypeDef *htim)
{
  if (htim->Instance == TIM1)
  {
    HAL_IncTick();
  }
}

/**
  * @brief  This function is executed in case of error occurrence.
  * @retval None
  */
void Error_Handler(void)
{
  /* USER CODE BEGIN Error_Handler_Debug */
  /* User can add his own implementation to report the HAL error return state */
  __disable_irq();
  while (1)
  {
  }
  /* USER CODE END Error_Handler_Debug */
}
#ifdef USE_FULL_ASSERT
/**
  * @brief  Reports the name of the source file and the source line number
  *         where the assert_param error has occurred.
  * @param  file: pointer to the source file name
  * @param  line: assert_param error line source number
  * @retval None
  */
void assert_failed(uint8_t *file, uint32_t line)
{
  /* USER CODE BEGIN 6 */
  /* User can add his own implementation to report the file name and line number,
     ex: printf("Wrong parameters value: file %s on line %d\r\n", file, line) */
  /* USER CODE END 6 */
}
#endif /* USE_FULL_ASSERT */
