cds-DEL/keshe/watch.ioc

Mcu.UserName=STM32F103C8Tx
PA1.Signal=GPIO_Input
PA10.Signal=USART1_RX
PA13.Signal=SYS_JTMS-SWDIO
PA14.Signal=SYS_JTCK-SWCLK
PA2.Signal=GPIO_Output
PA3.Signal=GPIO_Input
PA5.Signal=GPIO_Input
PA7.Signal=GPIO_Input
PA9.Signal=USART1_TX
PB0.Signal=GPIO_Output
PB1.Signal=GPIO_Input
PB10.Signal=I2C2_SCL
PB11.Signal=I2C2_SDA
PB12.Signal=GPIO_Input
PB13.Signal=GPIO_Input
PB14.Signal=GPIO_Input
PB8.Signal=I2C1_SCL
PB9.Signal=I2C1_SDA
PD0-OSC_IN.Signal=RCC_OSC_IN
PD1-OSC_OUT.Signal=RCC_OSC_OUT
