cds-DEL/keshe/Core/Inc/gpio.h

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
/* Define to prevent recursive inclusion -------------------------------------*/
#ifndef __GPIO_H__
#define __GPIO_H__

#ifdef __cplusplus
extern "C" {
#endif

/* Includes ------------------------------------------------------------------*/
#include "main.h"

/* USER CODE BEGIN Private defines */
#define TIME_ADJ_GPIO_PORT GPIOA
#define TIME_ADJ_HOUR_PIN GPIO_PIN_1
#define TIME_ADJ_MINUTE_PIN GPIO_PIN_3
#define TIME_ADJ_SECOND_PIN GPIO_PIN_5

/* USER CODE END Private defines */

void MX_GPIO_Init(void);

#ifdef __cplusplus
}
#endif
#endif /*__ GPIO_H__ */
