cds-DEL/keshe/(commit log)

2026-07-09 合并远程仓库代码
2026-07-09 完整上传单片机项目代码
2026-07-09 合并远程仓库，上传单片机代码Merge branch 'main' of https://github.com/cds-DEL/keshe
